ayesha-ishaq/AC-Multimeter-Arduino/(list of files, drawings)

Other design files:
ENA LAB.pdsprj
